rcyaon/chipathon-2026-ti-adc/README.md

## Associated repos
* [Browser-based layout planner](https://github.com/rcyaon/layout-planner)
* [Schematic area estimator](https://github.com/rcyaon/sch-area-estimator)
* [Image to GDS file converter](https://github.com/jazvw/chip_art)
