rcyaon/chipathon-2026-ti-adc/src/correction_top/tb/correction_sim_results_8bit.csv

idx | expected | actual | error | ch | gain_coeff | offset_reg | fifo_overflow
0 | 0.000000 | 0.000000 | 0.000000 | 0 | 1.000000 | 0.000000 | 0
1 | 2.208045 | 6.000000 | 3.791955 | 1 | 1.000000 | 0.000000 | 0
2 | 4.410771 | 4.000000 | -0.410771 | 0 | 1.000000 | 0.000000 | 0
3 | 6.602871 | 10.000000 | 3.397129 | 1 | 1.000000 | 0.000000 | 0
4 | 8.779064 | 9.000000 | 0.220936 | 0 | 1.000000 | 0.000000 | 0
5 | 10.934108 | 13.000000 | 2.065892 | 1 | 1.000000 | 0.000000 | 0
6 | 13.062810 | 13.000000 | -0.062810 | 0 | 1.000000 | 0.000000 | 0
7 | 15.160043 | 17.000000 | 1.839957 | 1 | 1.000000 | 0.000000 | 0
8 | 17.220754 | 17.000000 | -0.220754 | 0 | 1.000000 | 0.000000 | 0
9 | 19.239979 | 20.000000 | 0.760021 | 1 | 1.000000 | 0.000000 | 0
10 | 21.212853 | 21.000000 | -0.212853 | 0 | 1.000000 | 0.000000 | 0
11 | 23.134623 | 24.000000 | 0.865377 | 1 | 1.000000 | 0.000000 | 0
12 | 25.000660 | 25.000000 | -0.000660 | 0 | 1.000000 | 0.000000 | 0
13 | 26.806469 | 27.000000 | 0.193531 | 1 | 1.000000 | 0.000000 | 0
14 | 28.547698 | 29.000000 | 0.452302 | 0 | 1.000000 | 0.000000 | 0
15 | 30.220153 | 30.000000 | -0.220153 | 1 | 1.000000 | 0.000000 | 0
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
