rcyaon/chipathon-2026-ti-adc/analog/blocks/cdac/simulations/inl_dnl_results.csv

code | Vx | INL_ideal_LSB | DNL_ideal_LSB | INL_fit_LSB | DNL_fit_LSB
0 | -0.000005 | 0.0000 | 0.0000 | 0.0000 | 0.0000
1 | 0.006554 | -0.0671 | -0.0671 | -0.0088 | -0.0088
2 | 0.013149 | -0.1292 | -0.0621 | -0.0122 | -0.0035
3 | 0.019824 | -0.1798 | -0.0507 | -0.0036 | 0.0087
4 | 0.026340 | -0.2532 | -0.0733 | -0.0190 | -0.0154
5 | 0.033011 | -0.3043 | -0.0512 | -0.0108 | 0.0081
6 | 0.039546 | -0.3749 | -0.0706 | -0.0233 | -0.0125
7 | 0.046199 | -0.4288 | -0.0539 | -0.0180 | 0.0053
8 | 0.052720 | -0.5013 | -0.0725 | -0.0325 | -0.0145
9 | 0.059315 | -0.5634 | -0.0621 | -0.0360 | -0.0035
10 | 0.065910 | -0.6254 | -0.0620 | -0.0394 | -0.0033
11 | 0.072505 | -0.6874 | -0.0620 | -0.0428 | -0.0034
12 | 0.079110 | -0.7481 | -0.0607 | -0.0448 | -0.0020
13 | 0.085766 | -0.8014 | -0.0533 | -0.0389 | 0.0058
14 | 0.092291 | -0.8734 | -0.0720 | -0.0529 | -0.0140
15 | 0.098953 | -0.9260 | -0.0526 | -0.0463 | 0.0066
16 | 0.105865 | -0.9428 | -0.0168 | -0.0017 | 0.0446
17 | 0.112465 | -1.0042 | -0.0614 | -0.0044 | -0.0027
18 | 0.119059 | -1.0664 | -0.0622 | -0.0079 | -0.0036
19 | 0.125670 | -1.1262 | -0.0598 | -0.0090 | -0.0010
20 | 0.132248 | -1.1907 | -0.0645 | -0.0149 | -0.0060
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
