rcyaon/chipathon-2026-ti-adc/analog/top/top.spice

** sch_path: /foss/designs/proj_branch/chipathon-2026-ti-adc/analog/top/top.sch
**.subckt top
V8 CLK 0 PULSE(0 3.3 0 50p 50p 120n 250n)
V3 VDD 0 3.3
V1 RST 0 PULSE(3.3 0 0 1n 1n 15n 100000n)
V6 VIN 0 sin(0.825 0.75 100k 0)
V2 VRef 0 1.65
x6 net9 net10 net11 net12 VSAMPLE net13 net18 0 net14 net15 VRef net2 CLK net3 net4 VDD net5 VX net6 net7 VX_LSB net8 net16 caps
x1 0 VDD net4 net3 net2 net5 net11 net12 net9 net10 net7 net16 net6 net8 net13 net18 net14 net15 inverter_block
x5 net19 OUTP net1 0 VDD VX net17 realcomp
x3 VDD VSAMPLE CLK VIN 0 transmission_gate
X2 VDD 0 CLK_N net1 net2 net3 net4 net5 net6 net7 net8 net16 DOUT0 DOUT1 DOUT2 DOUT3 DOUT4 DOUT5 DOUT6 DOUT7 net19 OUTP RST
+ sar_adc_logic
V9 CLK_N 0 PULSE(3.3 0 0 50p 50p 120n 250n)
V10 net17 0 0.825
* Top-plate reset switches: pin VX and VX_LSB to VCM during sampling phase
XMrst1 VX CLK net17 0 nfet_03v3 L=0.28u W=2u nf=1
XMrst2 VX_LSB CLK net17 0 nfet_03v3 L=0.28u W=2u nf=1
**** begin user architecture code


.subckt sar_adc_logic VDD VSS clk_i clk_o dac_ctrl[0] dac_ctrl[1] dac_ctrl[2] dac_ctrl[3]
+ dac_ctrl[4] dac_ctrl[5] dac_ctrl[6] dac_ctrl[7] dout[0] dout[1] dout[2] dout[3]
+ dout[4] dout[5] dout[6] dout[7] out_n out_p rst_n
XFILLER_22_177 VDD VDD VSS VSS gf180mcu_fd_sc_mcu7t5v0__fillcap_16
XFILLER_9_137 VDD VDD VSS VSS gf180mcu_fd_sc_mcu7t5v0__fill_2
XFILLER_27_236 VDD VDD VSS VSS gf180mcu_fd_sc_mcu7t5v0__fillcap_4
XTAP_TAPCELL_ROW_8_88 VDD VSS gf180mcu_fd_sc_mcu7t5v0__filltie
XFILLER_6_107 VDD VDD VSS VSS gf180mcu_fd_sc_mcu7t5v0__fill_1
XFILLER_24_206 VDD VDD VSS VSS gf180mcu_fd_sc_mcu7t5v0__fill_1
XPHY_EDGE_ROW_20_Left_50 VDD VDD VSS VSS gf180mcu_fd_sc_mcu7t5v0__endcap
XFILLER_15_228 VDD VDD VSS VSS gf180mcu_fd_sc_mcu7t5v0__fillcap_8
X_062_ _064_/A1 _105_/Q _106_/Q _063_/B VDD VDD VSS VSS gf180mcu_fd_sc_mcu7t5v0__aoi21_1
XFILLER_21_209 VDD VDD VSS VSS gf180mcu_fd_sc_mcu7t5v0__fill_1
XFILLER_9_99 VDD VDD VSS VSS gf180mcu_fd_sc_mcu7t5v0__fill_2
XFILLER_9_88 VDD VDD VSS VSS gf180mcu_fd_sc_mcu7t5v0__fill_1
XFILLER_9_66 VDD VDD VSS VSS gf180mcu_fd_sc_mcu7t5v0__fillcap_4
XFILLER_18_53 VDD VDD VSS VSS gf180mcu_fd_sc_mcu7t5v0__fillcap_8
X_045_ _087_/Q _057_/A1 VDD VDD VSS VSS gf180mcu_fd_sc_mcu7t5v0__clkinv_1
XFILLER_28_183 VDD VDD VSS VSS gf180mcu_fd_sc_mcu7t5v0__fillcap_32
Xhold30 _083_/Q _097_/D VDD VDD VSS VSS gf180mcu_fd_sc_mcu7t5v0__dlyc_1
XFILLER_4_227 VDD VDD VSS VSS gf180mcu_fd_sc_mcu7t5v0__fillcap_8
Xrebuffer28 _108_/Q wire22/I VDD VDD VSS VSS gf180mcu_fd_sc_mcu7t5v0__buf_8
XFILLER_6_34 VDD VDD VSS VSS gf180mcu_fd_sc_mcu7t5v0__fill_1
XFILLER_15_98 VDD VDD VSS VSS gf180mcu_fd_sc_mcu7t5v0__fill_1
XFILLER_25_120 VDD VDD VSS VSS gf180mcu_fd_sc_mcu7t5v0__fill_1
XFILLER_16_197 VDD VDD VSS VSS gf180mcu_fd_sc_mcu7t5v0__fill_2
Xoutput7 _086_/Q dac_ctrl[3] VDD VDD VSS VSS gf180mcu_fd_sc_mcu7t5v0__dlyd_1
XFILLER_22_101 VDD VDD VSS VSS gf180mcu_fd_sc_mcu7t5v0__fillcap_4
XFILLER_22_123 VDD VDD VSS VSS gf180mcu_fd_sc_mcu7t5v0__fill_2
XFILLER_10_159 VDD VDD VSS VSS gf180mcu_fd_sc_mcu7t5v0__fillcap_4
XTAP_TAPCELL_ROW_8_89 VDD VSS gf180mcu_fd_sc_mcu7t5v0__filltie
XFILLER_23_240 VDD VDD VSS VSS gf180mcu_fd_sc_mcu7t5v0__fill_1
XPHY_EDGE_ROW_21_Right_21 VDD VDD VSS VSS gf180mcu_fd_sc_mcu7t5v0__endcap
XPHY_EDGE_ROW_12_Right_12 VDD VDD VSS VSS gf180mcu_fd_sc_mcu7t5v0__endcap
XFILLER_0_36 VDD VDD VSS VSS gf180mcu_fd_sc_mcu7t5v0__fillcap_32
XFILLER_14_240 VDD VDD VSS VSS gf180mcu_fd_sc_mcu7t5v0__fill_1
XFILLER_2_177 VDD VDD VSS VSS gf180mcu_fd_sc_mcu7t5v0__fillcap_16
X_061_ _061_/A1 _104_/Q _061_/B _085_/D VDD VDD VSS VSS gf180mcu_fd_sc_mcu7t5v0__oai21_1
XFILLER_3_2 VDD VDD VSS VSS gf180mcu_fd_sc_mcu7t5v0__fillcap_64
XFILLER_18_65 VDD VDD VSS VSS gf180mcu_fd_sc_mcu7t5v0__fill_1
X_044_ _088_/Q _055_/A1 VDD VDD VSS VSS gf180mcu_fd_sc_mcu7t5v0__clkinv_1
XTAP_TAPCELL_ROW_5_79 VDD VSS gf180mcu_fd_sc_mcu7t5v0__filltie
Xclkbuf_1_1__f_valid_clk_regs clkbuf_0_valid_clk_regs/Z _104_/CLK VDD VDD VSS VSS
+ gf180mcu_fd_sc_mcu7t5v0__clkbuf_16
Xhold31 _089_/Q _091_/D VDD VDD VSS VSS gf180mcu_fd_sc_mcu7t5v0__dlyc_1
XFILLER_4_239 VDD VDD VSS VSS gf180mcu_fd_sc_mcu7t5v0__fill_2
XFILLER_28_173 VDD VDD VSS VSS gf180mcu_fd_sc_mcu7t5v0__fill_2
XFILLER_15_66 VDD VDD VSS VSS gf180mcu_fd_sc_mcu7t5v0__fillcap_4
XPHY_EDGE_ROW_6_Right_6 VDD VDD VSS VSS gf180mcu_fd_sc_mcu7t5v0__endcap
Xoutput10 _083_/Q dac_ctrl[6] VDD VDD VSS VSS gf180mcu_fd_sc_mcu7t5v0__dlyd_1
Xoutput8 _085_/Q dac_ctrl[4] VDD VDD VSS VSS gf180mcu_fd_sc_mcu7t5v0__dlyd_1
XFILLER_9_139 VDD VDD VSS VSS gf180mcu_fd_sc_mcu7t5v0__fill_1
Xdly_stage[31].delay_buf dly_stage[31].delay_buf/I comp_trigger_driver/I VDD VDD
+ VSS VSS gf180mcu_fd_sc_mcu7t5v0__buf_1
XFILLER_12_34 VDD VDD VSS VSS gf180mcu_fd_sc_mcu7t5v0__fill_1
XFILLER_18_227 VDD VDD VSS VSS gf180mcu_fd_sc_mcu7t5v0__fillcap_8
XFILLER_23_66 VDD VDD VSS VSS gf180mcu_fd_sc_mcu7t5v0__fillcap_4
XFILLER_2_123 VDD VDD VSS VSS gf180mcu_fd_sc_mcu7t5v0__fillcap_4
X_060_ _064_/A1 _104_/Q _105_/Q _061_/B VDD VDD VSS VSS gf180mcu_fd_sc_mcu7t5v0__aoi21_1
XFILLER_29_2 VDD VDD VSS VSS gf180mcu_fd_sc_mcu7t5v0__fillcap_32
X_043_ _089_/Q _053_/A1 VDD VDD VSS VSS gf180mcu_fd_sc_mcu7t5v0__clkinv_1
XPHY_EDGE_ROW_8_Left_38 VDD VDD VSS VSS gf180mcu_fd_sc_mcu7t5v0__endcap
XFILLER_7_237 VDD VDD VSS VSS gf180mcu_fd_sc_mcu7t5v0__fillcap_4
XFILLER_20_34 VDD VDD VSS VSS gf180mcu_fd_sc_mcu7t5v0__fill_1
Xhold32 _084_/Q _096_/D VDD VDD VSS VSS gf180mcu_fd_sc_mcu7t5v0__dlyc_1
XFILLER_6_69 VDD VDD VSS VSS gf180mcu_fd_sc_mcu7t5v0__fill_2
XFILLER_15_89 VDD VDD VSS VSS gf180mcu_fd_sc_mcu7t5v0__fill_1
XFILLER_16_111 VDD VDD VSS VSS gf180mcu_fd_sc_mcu7t5v0__fill_2
Xdly_stage[30].delay_buf dly_stage[30].delay_buf/I dly_stage[31].delay_buf/I
+ VDD VDD VSS VSS gf180mcu_fd_sc_mcu7t5v0__buf_1
Xoutput11 _090_/Q dac_ctrl[7] VDD VDD VSS VSS gf180mcu_fd_sc_mcu7t5v0__dlyd_1
Xoutput9 _084_/Q dac_ctrl[5] VDD VDD VSS VSS gf180mcu_fd_sc_mcu7t5v0__dlyd_1
XFILLER_16_177 VDD VDD VSS VSS gf180mcu_fd_sc_mcu7t5v0__fillcap_16
XFILLER_16_199 VDD VDD VSS VSS gf180mcu_fd_sc_mcu7t5v0__fill_1
XFILLER_13_136 VDD VDD VSS VSS gf180mcu_fd_sc_mcu7t5v0__fillcap_4
XTAP_TAPCELL_ROW_15_109 VDD VSS gf180mcu_fd_sc_mcu7t5v0__filltie
XFILLER_12_57 VDD VDD VSS VSS gf180mcu_fd_sc_mcu7t5v0__fill_2
XFILLER_27_228 VDD VDD VSS VSS gf180mcu_fd_sc_mcu7t5v0__fillcap_8
XFILLER_18_239 VDD VDD VSS VSS gf180mcu_fd_sc_mcu7t5v0__fill_2
XPHY_EDGE_ROW_24_Left_54 VDD VDD VSS VSS gf180mcu_fd_sc_mcu7t5v0__endcap
X_042_ _107_/Q _108_/D VDD VDD VSS VSS gf180mcu_fd_sc_mcu7t5v0__clkinv_1
Xhold33 _085_/Q _095_/D VDD VDD VSS VSS gf180mcu_fd_sc_mcu7t5v0__dlyc_1
XFILLER_6_37 VDD VDD VSS VSS gf180mcu_fd_sc_mcu7t5v0__fillcap_32
XFILLER_19_142 VDD VDD VSS VSS gf180mcu_fd_sc_mcu7t5v0__fill_1
XFILLER_25_167 VDD VDD VSS VSS gf180mcu_fd_sc_mcu7t5v0__fill_1
XFILLER_25_178 VDD VDD VSS VSS gf180mcu_fd_sc_mcu7t5v0__fill_1
Xoutput12 _091_/Q dout[0] VDD VDD VSS VSS gf180mcu_fd_sc_mcu7t5v0__dlyd_1
XPHY_EDGE_ROW_11_Left_41 VDD VDD VSS VSS gf180mcu_fd_sc_mcu7t5v0__endcap
XFILLER_16_101 VDD VDD VSS VSS gf180mcu_fd_sc_mcu7t5v0__fillcap_4
XTAP_TAPCELL_ROW_18_118 VDD VSS gf180mcu_fd_sc_mcu7t5v0__filltie
XFILLER_26_34 VDD VDD VSS VSS gf180mcu_fd_sc_mcu7t5v0__fill_1
XFILLER_7_80 VDD VDD VSS VSS gf180mcu_fd_sc_mcu7t5v0__fillcap_4
XFILLER_10_107 VDD VDD VSS VSS gf180mcu_fd_sc_mcu7t5v0__fill_2
XTAP_TAPCELL_ROW_20_124 VDD VSS gf180mcu_fd_sc_mcu7t5v0__filltie
XFILLER_5_133 VDD VDD VSS VSS gf180mcu_fd_sc_mcu7t5v0__fill_2
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
XFILLER_17_237 VDD VDD VSS VSS gf180mcu_fd_sc_mcu7t5v0__fillcap_4
XFILLER_4_34 VDD VDD VSS VSS gf180mcu_fd_sc_mcu7t5v0__fill_1
XFILLER_4_130 VDD VDD VSS VSS gf180mcu_fd_sc_mcu7t5v0__fill_1
XFILLER_13_240 VDD VDD VSS VSS gf180mcu_fd_sc_mcu7t5v0__fill_1
X_093_ _093_/D _050_/I _094_/CLK _093_/Q VDD VDD VSS VSS gf180mcu_fd_sc_mcu7t5v0__dffrnq_1
XFILLER_6_203 VDD VDD VSS VSS gf180mcu_fd_sc_mcu7t5v0__fillcap_4
XFILLER_28_107 VDD VDD VSS VSS gf180mcu_fd_sc_mcu7t5v0__fillcap_32
Xinput1 out_n input1/Z VDD VDD VSS VSS gf180mcu_fd_sc_mcu7t5v0__dlyd_1
Xclkbuf_0_valid_clk_regs clkbuf_regs_0_valid_clk/Z clkbuf_0_valid_clk_regs/Z VDD VDD
+ VSS VSS gf180mcu_fd_sc_mcu7t5v0__clkbuf_16
X_076_ wire22/Z _077_/A2 _101_/RN VDD VDD VSS VSS gf180mcu_fd_sc_mcu7t5v0__nor2_1
XTAP_TAPCELL_ROW_29_157 VDD VSS gf180mcu_fd_sc_mcu7t5v0__filltie
XFILLER_18_173 VDD VDD VSS VSS gf180mcu_fd_sc_mcu7t5v0__fill_2
XTAP_TAPCELL_ROW_17_116 VDD VSS gf180mcu_fd_sc_mcu7t5v0__filltie
XFILLER_16_2 VDD VDD VSS VSS gf180mcu_fd_sc_mcu7t5v0__fillcap_32
X_059_ _059_/A1 _103_/Q _059_/B _086_/D VDD VDD VSS VSS gf180mcu_fd_sc_mcu7t5v0__oai21_1
XTAP_TAPCELL_ROW_22_130 VDD VSS gf180mcu_fd_sc_mcu7t5v0__filltie
XTAP_TAPCELL_ROW_14_108 VDD VSS gf180mcu_fd_sc_mcu7t5v0__filltie
XPHY_EDGE_ROW_9_Right_9 VDD VDD VSS VSS gf180mcu_fd_sc_mcu7t5v0__endcap
XFILLER_26_227 VDD VDD VSS VSS gf180mcu_fd_sc_mcu7t5v0__fillcap_8
XFILLER_23_208 VDD VDD VSS VSS gf180mcu_fd_sc_mcu7t5v0__fill_2
XFILLER_13_66 VDD VDD VSS VSS gf180mcu_fd_sc_mcu7t5v0__fillcap_4
XFILLER_9_212 VDD VDD VSS VSS gf180mcu_fd_sc_mcu7t5v0__fillcap_16
Xclkbuf_0_eoc_regs clkbuf_0_eoc_regs/I clkbuf_0_eoc_regs/Z VDD VDD VSS VSS gf180mcu_fd_sc_mcu7t5v0__clkbuf_16
X_092_ _092_/D _050_/I _094_/CLK _092_/Q VDD VDD VSS VSS gf180mcu_fd_sc_mcu7t5v0__dffrnq_1
XFILLER_10_34 VDD VDD VSS VSS gf180mcu_fd_sc_mcu7t5v0__fill_1
Xinput2 out_p wire26/I VDD VDD VSS VSS gf180mcu_fd_sc_mcu7t5v0__buf_1
XFILLER_19_119 VDD VDD VSS VSS gf180mcu_fd_sc_mcu7t5v0__fillcap_8
XFILLER_19_76 VDD VDD VSS VSS gf180mcu_fd_sc_mcu7t5v0__fill_2
XFILLER_19_87 VDD VDD VSS VSS gf180mcu_fd_sc_mcu7t5v0__fillcap_32
XFILLER_27_152 VDD VDD VSS VSS gf180mcu_fd_sc_mcu7t5v0__fill_1
X_075_ _108_/Q _077_/A2 _100_/RN VDD VDD VSS VSS gf180mcu_fd_sc_mcu7t5v0__nor2_1
XFILLER_21_66 VDD VDD VSS VSS gf180mcu_fd_sc_mcu7t5v0__fillcap_4
XFILLER_24_177 VDD VDD VSS VSS gf180mcu_fd_sc_mcu7t5v0__fillcap_4
Xmax_cap20 _080_/A2 _082_/A2 VDD VDD VSS VSS gf180mcu_fd_sc_mcu7t5v0__buf_2
XTAP_TAPCELL_ROW_17_117 VDD VSS gf180mcu_fd_sc_mcu7t5v0__filltie
X_058_ wire26/Z _103_/Q _104_/Q _059_/B VDD VDD VSS VSS gf180mcu_fd_sc_mcu7t5v0__aoi21_1
XFILLER_12_103 VDD VDD VSS VSS gf180mcu_fd_sc_mcu7t5v0__fill_2
XTAP_TAPCELL_ROW_22_131 VDD VSS gf180mcu_fd_sc_mcu7t5v0__filltie
XFILLER_8_107 VDD VDD VSS VSS gf180mcu_fd_sc_mcu7t5v0__fill_1
XFILLER_26_239 VDD VDD VSS VSS gf180mcu_fd_sc_mcu7t5v0__fill_2
XFILLER_4_165 VDD VDD VSS VSS gf180mcu_fd_sc_mcu7t5v0__fillcap_8
X_091_ _091_/D _050_/I _094_/CLK _091_/Q VDD VDD VSS VSS gf180mcu_fd_sc_mcu7t5v0__dffrnq_1
XFILLER_6_2 VDD VDD VSS VSS gf180mcu_fd_sc_mcu7t5v0__fillcap_32
XPHY_EDGE_ROW_27_Right_27 VDD VDD VSS VSS gf180mcu_fd_sc_mcu7t5v0__endcap
XPHY_EDGE_ROW_18_Right_18 VDD VDD VSS VSS gf180mcu_fd_sc_mcu7t5v0__endcap
XFILLER_27_120 VDD VDD VSS VSS gf180mcu_fd_sc_mcu7t5v0__fillcap_8
X_074_ _108_/Q _077_/A2 _099_/RN VDD VDD VSS VSS gf180mcu_fd_sc_mcu7t5v0__nor2_1
XPHY_EDGE_ROW_27_Left_57 VDD VDD VSS VSS gf180mcu_fd_sc_mcu7t5v0__endcap
XFILLER_24_101 VDD VDD VSS VSS gf180mcu_fd_sc_mcu7t5v0__fillcap_4
XFILLER_24_123 VDD VDD VSS VSS gf180mcu_fd_sc_mcu7t5v0__fillcap_4
Xclkbuf_1_0__f_valid_clk clkbuf_0_valid_clk/Z comp_trigger_nor/A1 VDD VDD VSS VSS
+ gf180mcu_fd_sc_mcu7t5v0__clkbuf_16
Xmax_cap21 _080_/A2 _077_/A2 VDD VDD VSS VSS gf180mcu_fd_sc_mcu7t5v0__buf_2
X_057_ _057_/A1 _102_/Q _057_/B _087_/D VDD VDD VSS VSS gf180mcu_fd_sc_mcu7t5v0__oai21_1
XTAP_TAPCELL_ROW_25_140 VDD VSS gf180mcu_fd_sc_mcu7t5v0__filltie
XFILLER_16_34 VDD VDD VSS VSS gf180mcu_fd_sc_mcu7t5v0__fill_1
XFILLER_21_104 VDD VDD VSS VSS gf180mcu_fd_sc_mcu7t5v0__fillcap_16
XFILLER_21_148 VDD VDD VSS VSS gf180mcu_fd_sc_mcu7t5v0__fillcap_4
XFILLER_12_159 VDD VDD VSS VSS gf180mcu_fd_sc_mcu7t5v0__fillcap_16
XTAP_TAPCELL_ROW_22_132 VDD VSS gf180mcu_fd_sc_mcu7t5v0__filltie
XPHY_EDGE_ROW_0_Right_0 VDD VDD VSS VSS gf180mcu_fd_sc_mcu7t5v0__endcap
XFILLER_21_2 VDD VDD VSS VSS gf180mcu_fd_sc_mcu7t5v0__fillcap_64
XPHY_EDGE_ROW_14_Left_44 VDD VDD VSS VSS gf180mcu_fd_sc_mcu7t5v0__endcap
XFILLER_25_240 VDD VDD VSS VSS gf180mcu_fd_sc_mcu7t5v0__fill_1
XFILLER_27_66 VDD VDD VSS VSS gf180mcu_fd_sc_mcu7t5v0__fillcap_4
XFILLER_16_240 VDD VDD VSS VSS gf180mcu_fd_sc_mcu7t5v0__fill_1
XFILLER_4_37 VDD VDD VSS VSS gf180mcu_fd_sc_mcu7t5v0__fillcap_16
XFILLER_4_100 VDD VDD VSS VSS gf180mcu_fd_sc_mcu7t5v0__fillcap_4
XFILLER_9_236 VDD VDD VSS VSS gf180mcu_fd_sc_mcu7t5v0__fillcap_4
XFILLER_5_80 VDD VDD VSS VSS gf180mcu_fd_sc_mcu7t5v0__fillcap_4
XFILLER_10_235 VDD VDD VSS VSS gf180mcu_fd_sc_mcu7t5v0__fillcap_4
XFILLER_24_34 VDD VDD VSS VSS gf180mcu_fd_sc_mcu7t5v0__fill_1
X_090_ _090_/D _073_/ZN _107_/CLK _090_/Q VDD VDD VSS VSS gf180mcu_fd_sc_mcu7t5v0__dffsnq_1
XFILLER_19_78 VDD VDD VSS VSS gf180mcu_fd_sc_mcu7t5v0__fill_1
XFILLER_18_8 VDD VDD VSS VSS gf180mcu_fd_sc_mcu7t5v0__fillcap_16
X_073_ wire22/Z _082_/A2 _073_/ZN VDD VDD VSS VSS gf180mcu_fd_sc_mcu7t5v0__nor2_1
XPHY_EDGE_ROW_2_Left_32 VDD VDD VSS VSS gf180mcu_fd_sc_mcu7t5v0__endcap
X_056_ wire26/Z _102_/Q _103_/Q _057_/B VDD VDD VSS VSS gf180mcu_fd_sc_mcu7t5v0__aoi21_2
XTAP_TAPCELL_ROW_25_141 VDD VSS gf180mcu_fd_sc_mcu7t5v0__filltie
XFILLER_14_2 VDD VDD VSS VSS gf180mcu_fd_sc_mcu7t5v0__fillcap_32
X_108_ _108_/D _050_/I clk_i _108_/Q VDD VDD VSS VSS gf180mcu_fd_sc_mcu7t5v0__dffrnq_4
XFILLER_17_208 VDD VDD VSS VSS gf180mcu_fd_sc_mcu7t5v0__fill_2
XFILLER_14_90 VDD VDD VSS VSS gf180mcu_fd_sc_mcu7t5v0__fillcap_8
XFILLER_5_240 VDD VDD VSS VSS gf180mcu_fd_sc_mcu7t5v0__fill_1
XFILLER_10_37 VDD VDD VSS VSS gf180mcu_fd_sc_mcu7t5v0__fillcap_16
XFILLER_19_68 VDD VDD VSS VSS gf180mcu_fd_sc_mcu7t5v0__fill_2
X_072_ _108_/Q _077_/A2 _089_/RN VDD VDD VSS VSS gf180mcu_fd_sc_mcu7t5v0__nor2_1
XTAP_TAPCELL_ROW_28_150 VDD VSS gf180mcu_fd_sc_mcu7t5v0__filltie
XFILLER_15_158 VDD VDD VSS VSS gf180mcu_fd_sc_mcu7t5v0__fillcap_4
Xdly_stage[19].delay_buf dly_stage[19].delay_buf/I dly_stage[20].delay_buf/I
+ VDD VDD VSS VSS gf180mcu_fd_sc_mcu7t5v0__buf_1
X_055_ _055_/A1 _101_/Q _055_/B _088_/D VDD VDD VSS VSS gf180mcu_fd_sc_mcu7t5v0__oai21_1
XFILLER_11_80 VDD VDD VSS VSS gf180mcu_fd_sc_mcu7t5v0__fillcap_4
XFILLER_21_128 VDD VDD VSS VSS gf180mcu_fd_sc_mcu7t5v0__fillcap_4
XFILLER_29_206 VDD VDD VSS VSS gf180mcu_fd_sc_mcu7t5v0__fillcap_32
X_107_ _107_/D _082_/ZN _107_/CLK _107_/Q VDD VDD VSS VSS gf180mcu_fd_sc_mcu7t5v0__dffsnq_2
XFILLER_4_124 VDD VDD VSS VSS gf180mcu_fd_sc_mcu7t5v0__fill_1
XFILLER_22_201 VDD VDD VSS VSS gf180mcu_fd_sc_mcu7t5v0__fillcap_4
XFILLER_13_212 VDD VDD VSS VSS gf180mcu_fd_sc_mcu7t5v0__fillcap_16
XFILLER_19_36 VDD VDD VSS VSS gf180mcu_fd_sc_mcu7t5v0__fillcap_32
XFILLER_2_233 VDD VDD VSS VSS gf180mcu_fd_sc_mcu7t5v0__fillcap_8
Xdly_stage[18].delay_buf dly_stage[18].delay_buf/I dly_stage[19].delay_buf/I
+ VDD VDD VSS VSS gf180mcu_fd_sc_mcu7t5v0__buf_1
X_071_ _108_/Q _077_/A2 _088_/RN VDD VDD VSS VSS gf180mcu_fd_sc_mcu7t5v0__nor2_1
XPHY_EDGE_ROW_23_Right_23 VDD VDD VSS VSS gf180mcu_fd_sc_mcu7t5v0__endcap
XPHY_EDGE_ROW_14_Right_14 VDD VDD VSS VSS gf180mcu_fd_sc_mcu7t5v0__endcap
XFILLER_4_2 VDD VDD VSS VSS gf180mcu_fd_sc_mcu7t5v0__fillcap_32
XFILLER_15_137 VDD VDD VSS VSS gf180mcu_fd_sc_mcu7t5v0__fill_2
XFILLER_23_192 VDD VDD VSS VSS gf180mcu_fd_sc_mcu7t5v0__fillcap_16
X_054_ _064_/A1 _101_/Q _102_/Q _055_/B VDD VDD VSS VSS gf180mcu_fd_sc_mcu7t5v0__aoi21_1
XFILLER_12_107 VDD VDD VSS VSS gf180mcu_fd_sc_mcu7t5v0__fill_2
XFILLER_16_37 VDD VDD VSS VSS gf180mcu_fd_sc_mcu7t5v0__fillcap_16
XFILLER_20_173 VDD VDD VSS VSS gf180mcu_fd_sc_mcu7t5v0__fill_2
X_106_ _107_/Q _106_/RN _107_/CLK _106_/Q VDD VDD VSS VSS gf180mcu_fd_sc_mcu7t5v0__dffrnq_2
XFILLER_19_240 VDD VDD VSS VSS gf180mcu_fd_sc_mcu7t5v0__fill_1
XPHY_EDGE_ROW_4_Right_4 VDD VDD VSS VSS gf180mcu_fd_sc_mcu7t5v0__endcap
XPHY_EDGE_ROW_18_Left_48 VDD VDD VSS VSS gf180mcu_fd_sc_mcu7t5v0__endcap
XFILLER_0_172 VDD VDD VSS VSS gf180mcu_fd_sc_mcu7t5v0__fillcap_4
XFILLER_9_228 VDD VDD VSS VSS gf180mcu_fd_sc_mcu7t5v0__fillcap_8
XFILLER_10_227 VDD VDD VSS VSS gf180mcu_fd_sc_mcu7t5v0__fillcap_8
XFILLER_24_37 VDD VDD VSS VSS gf180mcu_fd_sc_mcu7t5v0__fillcap_64
Xdly_stage[17].delay_buf dly_stage[17].delay_buf/I dly_stage[18].delay_buf/I
+ VDD VDD VSS VSS gf180mcu_fd_sc_mcu7t5v0__buf_1
XFILLER_5_72 VDD VDD VSS VSS gf180mcu_fd_sc_mcu7t5v0__fillcap_8
XFILLER_14_81 VDD VDD VSS VSS gf180mcu_fd_sc_mcu7t5v0__fill_2
X_070_ wire22/Z _077_/A2 _087_/RN VDD VDD VSS VSS gf180mcu_fd_sc_mcu7t5v0__nor2_1
XFILLER_18_102 VDD VDD VSS VSS gf180mcu_fd_sc_mcu7t5v0__fill_2
XFILLER_15_105 VDD VDD VSS VSS gf180mcu_fd_sc_mcu7t5v0__fillcap_32
XFILLER_24_127 VDD VDD VSS VSS gf180mcu_fd_sc_mcu7t5v0__fill_2
Xmax_cap25 wire26/Z _064_/A1 VDD VDD VSS VSS gf180mcu_fd_sc_mcu7t5v0__buf_2
XPHY_EDGE_ROW_6_Left_36 VDD VDD VSS VSS gf180mcu_fd_sc_mcu7t5v0__endcap
XFILLER_11_93 VDD VDD VSS VSS gf180mcu_fd_sc_mcu7t5v0__fillcap_16
X_053_ _053_/A1 _100_/Q _053_/B _089_/D VDD VDD VSS VSS gf180mcu_fd_sc_mcu7t5v0__oai21_1
XFILLER_20_185 VDD VDD VSS VSS gf180mcu_fd_sc_mcu7t5v0__fillcap_4
X_105_ _106_/Q _105_/RN _107_/CLK _105_/Q VDD VDD VSS VSS gf180mcu_fd_sc_mcu7t5v0__dffrnq_2
XTAP_TAPCELL_ROW_13_103 VDD VSS gf180mcu_fd_sc_mcu7t5v0__filltie
XFILLER_4_104 VDD VDD VSS VSS gf180mcu_fd_sc_mcu7t5v0__fill_1
XFILLER_12_2 VDD VDD VSS VSS gf180mcu_fd_sc_mcu7t5v0__fillcap_32
Xdly_stage[16].delay_buf dly_stage[16].delay_buf/I dly_stage[17].delay_buf/I
+ VDD VDD VSS VSS gf180mcu_fd_sc_mcu7t5v0__buf_1
XFILLER_13_236 VDD VDD VSS VSS gf180mcu_fd_sc_mcu7t5v0__fillcap_4
XFILLER_5_84 VDD VDD VSS VSS gf180mcu_fd_sc_mcu7t5v0__fill_2
XFILLER_10_239 VDD VDD VSS VSS gf180mcu_fd_sc_mcu7t5v0__fill_2
XFILLER_18_169 VDD VDD VSS VSS gf180mcu_fd_sc_mcu7t5v0__fillcap_4
XPHY_EDGE_ROW_22_Left_52 VDD VDD VSS VSS gf180mcu_fd_sc_mcu7t5v0__endcap
XFILLER_15_139 VDD VDD VSS VSS gf180mcu_fd_sc_mcu7t5v0__fill_1
X_052_ _064_/A1 _100_/Q _101_/Q _053_/B VDD VDD VSS VSS gf180mcu_fd_sc_mcu7t5v0__aoi21_1
XFILLER_14_161 VDD VDD VSS VSS gf180mcu_fd_sc_mcu7t5v0__fill_2
XTAP_TAPCELL_ROW_16_112 VDD VSS gf180mcu_fd_sc_mcu7t5v0__filltie
XFILLER_20_131 VDD VDD VSS VSS gf180mcu_fd_sc_mcu7t5v0__fillcap_4
XFILLER_28_231 VDD VDD VSS VSS gf180mcu_fd_sc_mcu7t5v0__fillcap_8
XTAP_TAPCELL_ROW_13_104 VDD VSS gf180mcu_fd_sc_mcu7t5v0__filltie
XFILLER_11_131 VDD VDD VSS VSS gf180mcu_fd_sc_mcu7t5v0__fill_1
XFILLER_11_164 VDD VDD VSS VSS gf180mcu_fd_sc_mcu7t5v0__fill_2
X_104_ _105_/Q _104_/RN _104_/CLK _104_/Q VDD VDD VSS VSS gf180mcu_fd_sc_mcu7t5v0__dffrnq_2
Xdly_stage[15].delay_buf dly_stage[15].delay_buf/I dly_stage[16].delay_buf/I
+ VDD VDD VSS VSS gf180mcu_fd_sc_mcu7t5v0__buf_1
XFILLER_25_201 VDD VDD VSS VSS gf180mcu_fd_sc_mcu7t5v0__fillcap_8
XFILLER_25_212 VDD VDD VSS VSS gf180mcu_fd_sc_mcu7t5v0__fillcap_16
XFILLER_16_234 VDD VDD VSS VSS gf180mcu_fd_sc_mcu7t5v0__fillcap_4
Xclkbuf_regs_1_eoc_clk _099_/Q clkbuf_0_eoc_regs/I VDD VDD VSS VSS gf180mcu_fd_sc_mcu7t5v0__clkbuf_16
Xclkbuf_1_1__f_eoc_regs clkbuf_0_eoc_regs/Z _094_/CLK VDD VDD VSS VSS gf180mcu_fd_sc_mcu7t5v0__clkbuf_16
XFILLER_14_83 VDD VDD VSS VSS gf180mcu_fd_sc_mcu7t5v0__fill_1
XFILLER_27_104 VDD VDD VSS VSS gf180mcu_fd_sc_mcu7t5v0__fillcap_16
XFILLER_27_148 VDD VDD VSS VSS gf180mcu_fd_sc_mcu7t5v0__fillcap_4
XFILLER_18_104 VDD VDD VSS VSS gf180mcu_fd_sc_mcu7t5v0__fill_1
XFILLER_18_115 VDD VDD VSS VSS gf180mcu_fd_sc_mcu7t5v0__fillcap_4
XFILLER_24_107 VDD VDD VSS VSS gf180mcu_fd_sc_mcu7t5v0__fillcap_16
XFILLER_24_129 VDD VDD VSS VSS gf180mcu_fd_sc_mcu7t5v0__fill_1
XTAP_TAPCELL_ROW_19_121 VDD VSS gf180mcu_fd_sc_mcu7t5v0__filltie
XPHY_EDGE_ROW_10_Right_10 VDD VDD VSS VSS gf180mcu_fd_sc_mcu7t5v0__endcap
XFILLER_11_84 VDD VDD VSS VSS gf180mcu_fd_sc_mcu7t5v0__fill_2
XFILLER_2_2 VDD VDD VSS VSS gf180mcu_fd_sc_mcu7t5v0__fillcap_32
X_051_ _090_/Q wire26/Z _107_/Q _090_/D VDD VDD VSS VSS gf180mcu_fd_sc_mcu7t5v0__mux2_2
Xdly_stage[14].delay_buf dly_stage[14].delay_buf/I dly_stage[15].delay_buf/I
+ VDD VDD VSS VSS gf180mcu_fd_sc_mcu7t5v0__buf_1
XTAP_TAPCELL_ROW_7_85 VDD VSS gf180mcu_fd_sc_mcu7t5v0__filltie
XTAP_TAPCELL_ROW_16_113 VDD VSS gf180mcu_fd_sc_mcu7t5v0__filltie
XFILLER_20_165 VDD VDD VSS VSS gf180mcu_fd_sc_mcu7t5v0__fillcap_8
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
