rcyaon/chipathon-2026-ti-adc/analog/digital/SAR_ADC_LOGIC/sar_adc_logic.spice

.subckt sar_adc_logic VDD VSS clk_i clk_o d_ctrl[0] d_ctrl[1] d_ctrl[2] d_ctrl[3]
    + d_ctrl[4] d_ctrl[5] d_ctrl[6] d_ctrl[7] d_ctrl_n[0] d_ctrl_n[1] d_ctrl_n[2] d_ctrl_n[3]
    + d_ctrl_n[4] d_ctrl_n[5] d_ctrl_n[6] d_ctrl_n[7] d_out[0] d_out[1] d_out[2] d_out[3]
    + d_out[4] d_out[5] d_out[6] d_out[7] out_n out_p phi_bottom phi_bottom_n phi_top
    + phi_top_n rst_n
    XFILLER_54_247 VDD VDD VSS VSS gf180mcu_fd_sc_mcu7t5v0__fillcap_64
    XFILLER_50_453 VDD VDD VSS VSS gf180mcu_fd_sc_mcu7t5v0__fill_2
    XFILLER_10_317 VDD VDD VSS VSS gf180mcu_fd_sc_mcu7t5v0__fillcap_8
    XFILLER_22_177 VDD VDD VSS VSS gf180mcu_fd_sc_mcu7t5v0__fillcap_64
    XTAP_TAPCELL_ROW_43_448 VDD VSS gf180mcu_fd_sc_mcu7t5v0__filltie
    XFILLER_67_70 VDD VDD VSS VSS gf180mcu_fd_sc_mcu7t5v0__fillcap_32
    XFILLER_36_247 VDD VDD VSS VSS gf180mcu_fd_sc_mcu7t5v0__fillcap_64
    XFILLER_51_206 VDD VDD VSS VSS gf180mcu_fd_sc_mcu7t5v0__fillcap_4
    XFILLER_6_107 VDD VDD VSS VSS gf180mcu_fd_sc_mcu7t5v0__fillcap_64
    XFILLER_23_464 VDD VDD VSS VSS gf180mcu_fd_sc_mcu7t5v0__fill_1
    XTAP_TAPCELL_ROW_40_429 VDD VSS gf180mcu_fd_sc_mcu7t5v0__filltie
    XFILLER_2_357 VDD VDD VSS VSS gf180mcu_fd_sc_mcu7t5v0__fillcap_16
    XTAP_TAPCELL_ROW_56_540 VDD VSS gf180mcu_fd_sc_mcu7t5v0__filltie
    XTAP_TAPCELL_ROW_5_184 VDD VSS gf180mcu_fd_sc_mcu7t5v0__filltie
    XFILLER_18_247 VDD VDD VSS VSS gf180mcu_fd_sc_mcu7t5v0__fillcap_64
    XFILLER_61_504 VDD VDD VSS VSS gf180mcu_fd_sc_mcu7t5v0__fillcap_4
    XFILLER_53_72 VDD VDD VSS VSS gf180mcu_fd_sc_mcu7t5v0__fillcap_64
    XFILLER_14_453 VDD VDD VSS VSS gf180mcu_fd_sc_mcu7t5v0__fill_2
    XFILLER_33_206 VDD VDD VSS VSS gf180mcu_fd_sc_mcu7t5v0__fillcap_4
    XFILLER_20_489 VDD VDD VSS VSS gf180mcu_fd_sc_mcu7t5v0__fill_2
    X_068__57 _068__59/I _091_/A4 VDD VDD VSS VSS gf180mcu_fd_sc_mcu7t5v0__clkinv_1
    XFILLER_59_136 VDD VDD VSS VSS gf180mcu_fd_sc_mcu7t5v0__fillcap_4
    XFILLER_43_504 VDD VDD VSS VSS gf180mcu_fd_sc_mcu7t5v0__fillcap_4
    XFILLER_15_206 VDD VDD VSS VSS gf180mcu_fd_sc_mcu7t5v0__fillcap_4
    X_131_ _131_/D _133_/RN _133_/CLK _131_/Q VDD VDD VSS VSS gf180mcu_fd_sc_mcu7t5v0__dffrnq_1
    XFILLER_11_434 VDD VDD VSS VSS gf180mcu_fd_sc_mcu7t5v0__fillcap_8
    XFILLER_11_489 VDD VDD VSS VSS gf180mcu_fd_sc_mcu7t5v0__fill_1
    X_062_ _123_/Q _096_/A1 VDD VDD VSS VSS gf180mcu_fd_sc_mcu7t5v0__inv_2
    XFILLER_9_66 VDD VDD VSS VSS gf180mcu_fd_sc_mcu7t5v0__fillcap_4
    XTAP_TAPCELL_ROW_16_256 VDD VSS gf180mcu_fd_sc_mcu7t5v0__filltie
    Xclkbuf_leaf_1_net28 clkload0/I _108_/A1 VDD VDD VSS VSS gf180mcu_fd_sc_mcu7t5v0__clkbuf_8
    XFILLER_43_2 VDD VDD VSS VSS gf180mcu_fd_sc_mcu7t5v0__fillcap_64
    XTAP_TAPCELL_ROW_67_624 VDD VSS gf180mcu_fd_sc_mcu7t5v0__filltie
    XTAP_TAPCELL_ROW_67_613 VDD VSS gf180mcu_fd_sc_mcu7t5v0__filltie
    Xdly_stage\[33\].delay_buf dly_stage\[33\].delay_buf/I dly_stage\[34\].delay_buf/I
    + VDD VDD VSS VSS gf180mcu_fd_sc_mcu7t5v0__buf_1
    XFILLER_40_507 VDD VDD VSS VSS gf180mcu_fd_sc_mcu7t5v0__fill_2
    XTAP_TAPCELL_ROW_13_237 VDD VSS gf180mcu_fd_sc_mcu7t5v0__filltie
    XFILLER_3_430 VDD VDD VSS VSS gf180mcu_fd_sc_mcu7t5v0__fill_1
    X_114_ _117_/A1 _117_/A2 _139_/RN VDD VDD VSS VSS gf180mcu_fd_sc_mcu7t5v0__nor2_1
    XTAP_TAPCELL_ROW_21_292 VDD VSS gf180mcu_fd_sc_mcu7t5v0__filltie
    XFILLER_61_142 VDD VDD VSS VSS gf180mcu_fd_sc_mcu7t5v0__fillcap_64
    XFILLER_22_507 VDD VDD VSS VSS gf180mcu_fd_sc_mcu7t5v0__fill_2
    XPHY_EDGE_ROW_28_Left_96 VDD VDD VSS VSS gf180mcu_fd_sc_mcu7t5v0__endcap
    XFILLER_65_492 VDD VDD VSS VSS gf180mcu_fd_sc_mcu7t5v0__fillcap_16
    XTAP_TAPCELL_ROW_10_218 VDD VSS gf180mcu_fd_sc_mcu7t5v0__filltie
    XFILLER_0_444 VDD VDD VSS VSS gf180mcu_fd_sc_mcu7t5v0__fillcap_32
    Xhold74 _125_/Q _133_/D VDD VDD VSS VSS gf180mcu_fd_sc_mcu7t5v0__dlyc_1
    XFILLER_43_142 VDD VDD VSS VSS gf180mcu_fd_sc_mcu7t5v0__fillcap_64
    XFILLER_61_72 VDD VDD VSS VSS gf180mcu_fd_sc_mcu7t5v0__fillcap_64
    XFILLER_6_34 VDD VDD VSS VSS gf180mcu_fd_sc_mcu7t5v0__fill_1
    XFILLER_3_282 VDD VDD VSS VSS gf180mcu_fd_sc_mcu7t5v0__fillcap_32
    XTAP_TAPCELL_ROW_49_487 VDD VSS gf180mcu_fd_sc_mcu7t5v0__filltie
    XFILLER_47_492 VDD VDD VSS VSS gf180mcu_fd_sc_mcu7t5v0__fillcap_16
    XFILLER_62_451 VDD VDD VSS VSS gf180mcu_fd_sc_mcu7t5v0__fillcap_4
    XFILLER_30_381 VDD VDD VSS VSS gf180mcu_fd_sc_mcu7t5v0__fillcap_4
    XFILLER_57_212 VDD VDD VSS VSS gf180mcu_fd_sc_mcu7t5v0__fillcap_64
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
    XFILLER_25_136 VDD VDD VSS VSS gf180mcu_fd_sc_mcu7t5v0__fillcap_4
    XFILLER_5_508 VDD VDD VSS VSS gf180mcu_fd_sc_mcu7t5v0__fill_1
    Xoutput25 _131_/Q d_out[5] VDD VDD VSS VSS gf180mcu_fd_sc_mcu7t5v0__dlyd_1
    Xoutput14 _091_/ZN d_ctrl_n[2] VDD VDD VSS VSS gf180mcu_fd_sc_mcu7t5v0__buf_2
    XFILLER_44_401 VDD VDD VSS VSS gf180mcu_fd_sc_mcu7t5v0__fill_2
    Xclkbuf_1_0__f_eoc clkbuf_0_eoc/Z _096_/A4 VDD VDD VSS VSS gf180mcu_fd_sc_mcu7t5v0__clkbuf_16
    XFILLER_29_464 VDD VDD VSS VSS gf180mcu_fd_sc_mcu7t5v0__fill_1
    Xclkbuf_1_0__f_clk_i clkbuf_0_clk_i/Z phi_top_inv_37/I VDD VDD VSS VSS gf180mcu_fd_sc_mcu7t5v0__clkbuf_16
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
