rcyaon/chipathon-2026-ti-adc/(commit log)

2026-06-30 Symbol and testbench of ideal comparator
    [IDcomptest.sch]
2026-07-04 Fixed timing issues of sar adc logic
    [sar_adc_logic.sv]
2026-07-05 cdac and calcs
    [IDcomptest.sch, caps.sch, caps_tb.sch, transistors.sch]
2026-07-05 including more cdac progress
    [inl_dnl_results.csv, transistors.sch]
2026-07-05 Added all digital correction rtl
    [correction_sim_results_8bit.csv]
2026-07-10 Adding the real comparator files
    [realcomp.sch, realcomptest.sch]
2026-07-15 spi2xspice.py changes
    Sets the voltage when you run the script, instead of having to open the code and change a number by hand every time.
2026-07-19 top level sch
    [top.sch]
2026-07-19 Symbol, testbench, and spicefile of SAR logic
    [sar_logic_test.sch]
